xioTechnologies/PIC32MZ-Bare-Bones/README.md

PIC32MZ-Bare-Bones
==================

This is a bare-bones development board for the new high-performance [Microchip PIC32MZ](http://www.microchip.com/design-centers/32-bit), compatible with any of the 144-pin variants: [PIC32MZxxxxEFx144-PL](http://www.microchip.com/wwwproducts/Devices.aspx?product=PIC32MZ2048EFH144).  The board is a minimal design intended to be used in conjunction with an [ICD3](http://www.microchip.com/stellent/idcplg?IdcService=SS_GET_PAGE&nodeId=1406&dDocName=en537580).  All of the pins have been broken out to female headers for connections via jumper wires or a mating 'daughter-board' with a matching male headers.

Features
--------

* Primary oscillator crystal (24 MHz)
* Secondary oscillator crystal (32.768 kHz for RTC)
* [ICD3](http://www.microchip.com/stellent/idcplg?IdcService=SS_GET_PAGE&nodeId=1406&dDocName=en537580) socket or [PICKit3](http://www.microchip.com/stellent/idcplg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) header
* Reset button
* [FTDI header](https://www.sparkfun.com/products/9716) with connections to UART1 (also provides power)
* USB A (host) and micro USB B (device) sockets
* [3.3 V, 1 A dropout regulator](http://www.analog.com/en/power-management/linear-regulators/adp3338/products/product.html)

Images
------

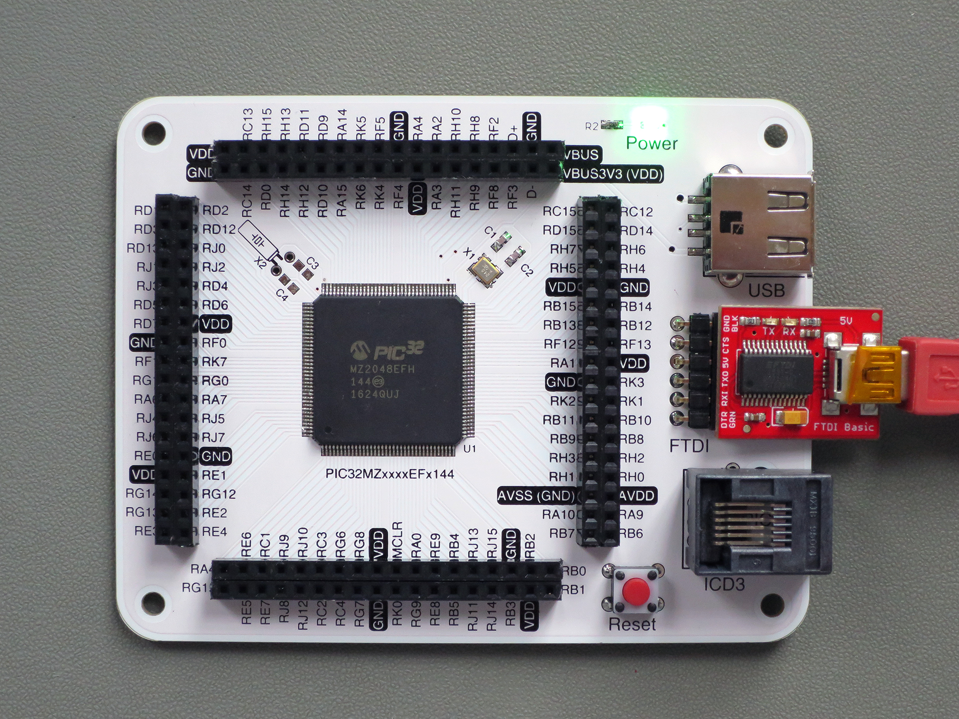
[picture p1: PCB Top.jpg]


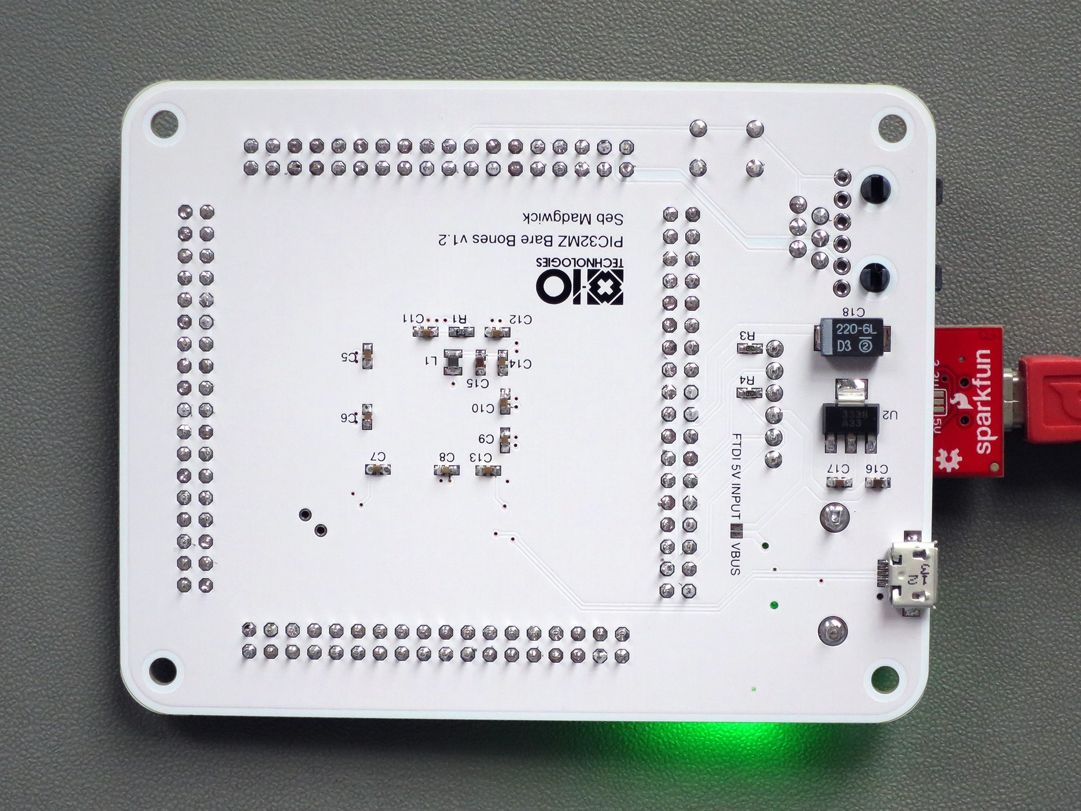
[picture p2: PCB Bottom.jpg]
