xioTechnologies/PIC32MZ-Bare-Bones/PCB/PIC32MZ Bare Bones Schematic.pdf

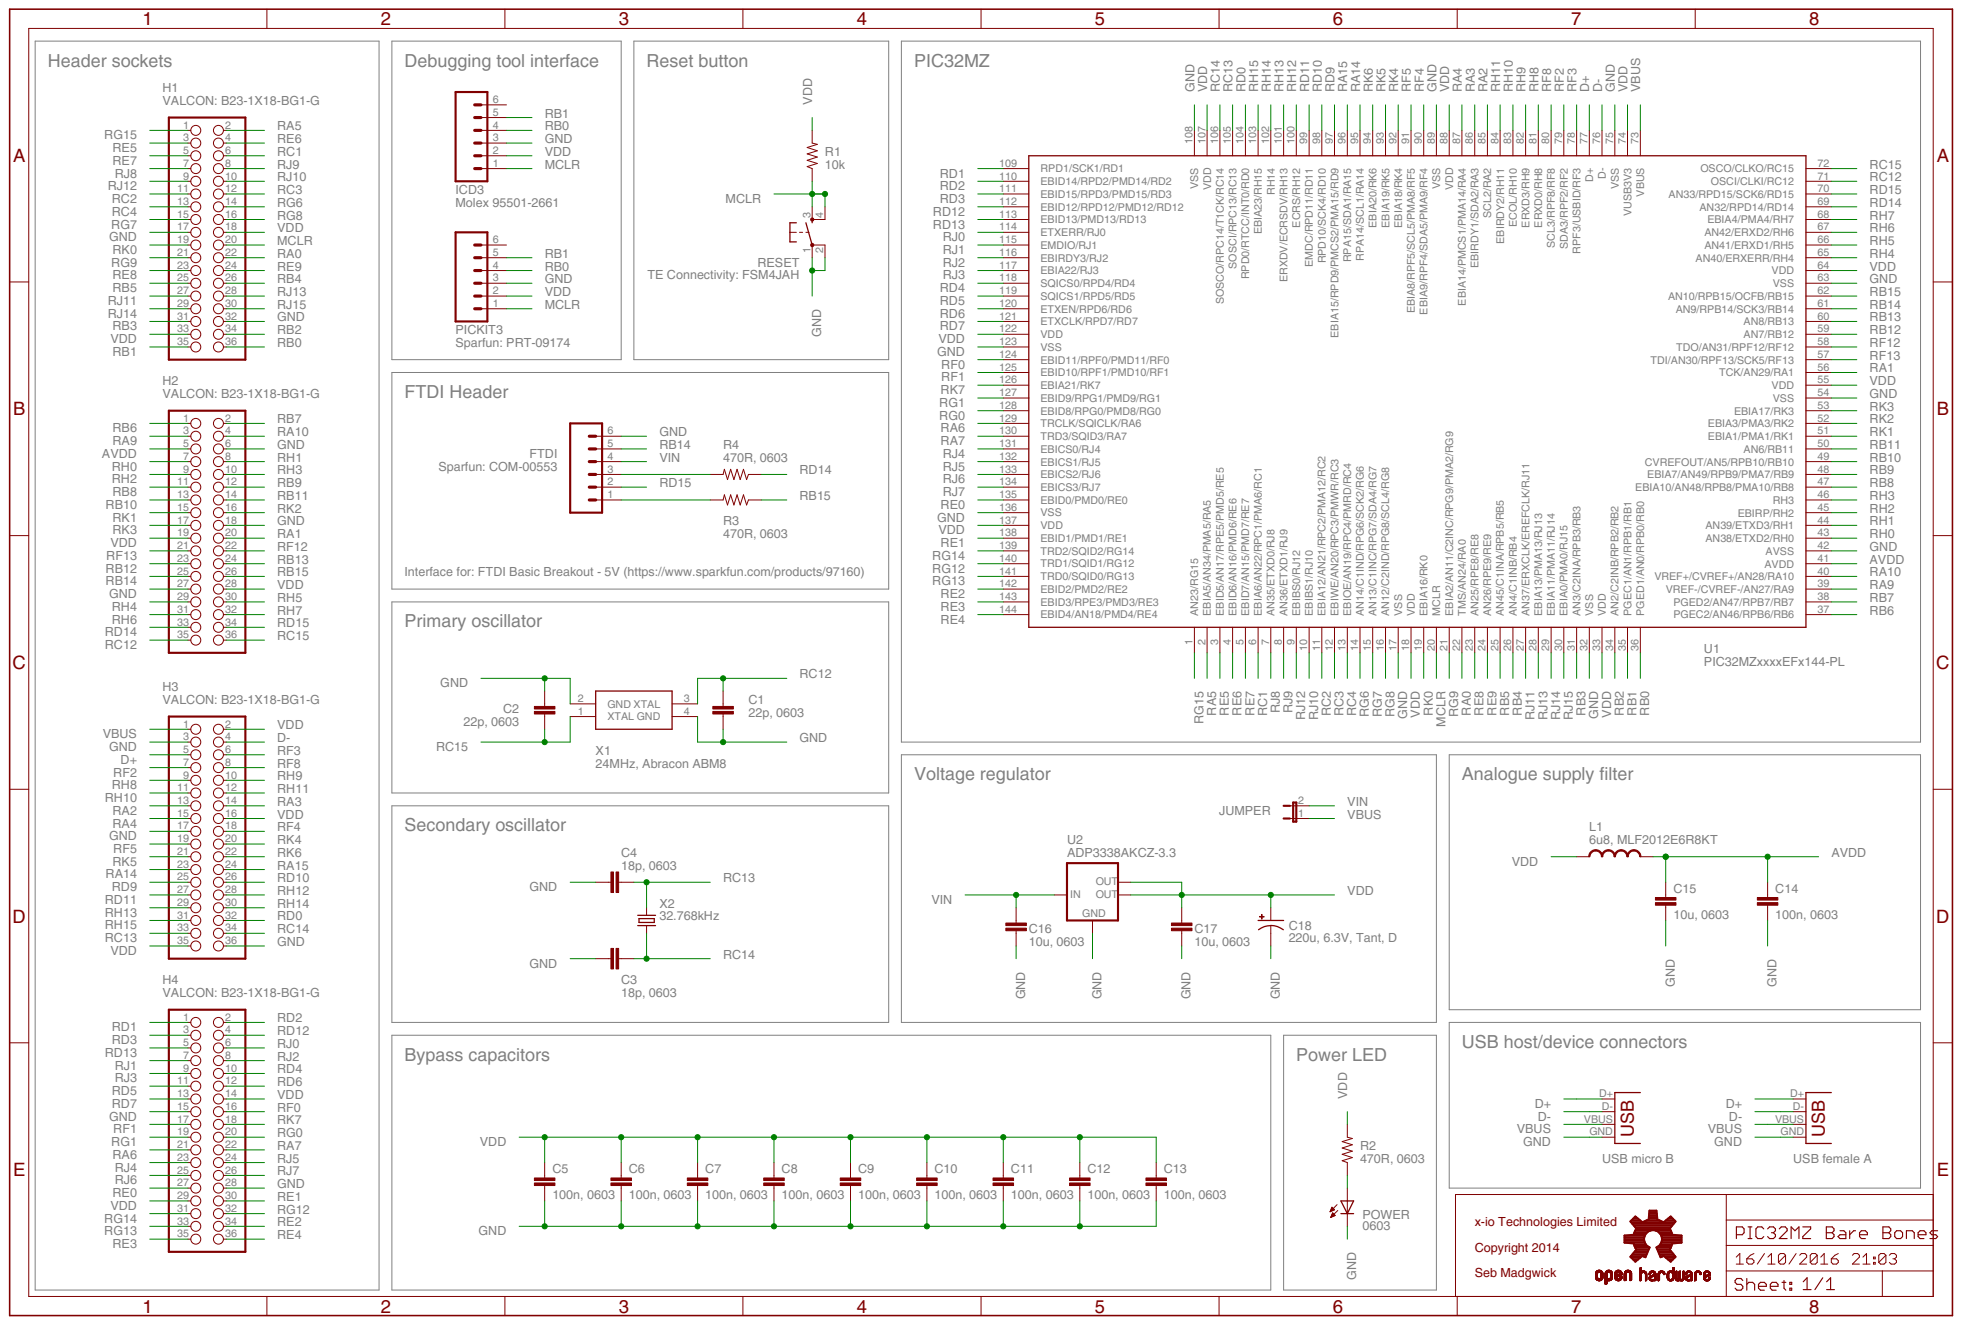
[picture p3: page 1]

Interface for: FTDI Basic Breakout - 5V (https://www.sparkfun.com/products/97160)

GND GND

USB host/device connectors
