xioTechnologies/PIC32MZ-Bare-Bones/(threads)

Thread 1 (2016-01-03):

RF4 bug

Vosselectronics, 2016-01-03:
Hi, just a comment. RF4 is duplicated on the upper side of the board. Left side of GND should be RF5 instead of RF4 and RF5 on the line of VDD should be RK4. Rest are OK.
Thanks, it´s a great board.

xioTechnologies, 2016-10-16:
Thank you for the feedback.  This will be fixed in v1.2.

Closed 2016-10-16.
