xioTechnologies/PIC32MZ-Bare-Bones/(commit log)

2014-01-13 Add PCB CAD files
    [PIC32MZ Bare Bones.sch]
2014-01-13 Add image of PCB in Eagle
2014-01-13 Move trace for RA4
2014-01-14 Minor aesthetics changes to board
2014-01-15 Correct LQFP foot print to match datasheet
    [PIC32MZ Bare Bones.sch]
2014-03-12 Remove battery, add USB host/device sockets
    [PIC32MZ Bare Bones.sch]
2014-03-17 Add missing via drills
2014-03-27 5V tolerance for FTDI inputs
    [PIC32MZ Bare Bones.sch]
2014-04-04 Add photos of PCB
2016-10-16 Fix incorrect labels for RF5 and RK5
    [PIC32MZ Bare Bones.sch]
2016-10-16 Change some component value and part numbers
    [PIC32MZ Bare Bones.sch]
2016-10-16 Create Gerbers for v1.2 PCB
    [PIC32MZ Bare Bones.sch]
2016-10-16 Add silkscreen bitmap files
2016-10-24 Add PCB photos
